rebedmos/Teremin-Eletronico/README.md

# Teremin-Eletronico
O presente projeto foi feito em 2016 e teve como objetivo aplicar:
- a criação de um conceito de projeto;
- a possibilidade de visão e operação macro e micro de um projeto de engenharia;
- o gerenciamento do projeto por meio do Project Model CANVAS;
- o estudo específico do microcontrolador RL78/G13 (arquitetura, utilização de registradores e bibliotecas);
- aplicação técnica de conhecimentos de hardware (circuitos, modulação de sinais, filtros, desacoplamento, DAC, buffer, amplificação de corrente para drive de motor, fontes, regulagem de offset, montagem, etc) e software (utilização da IDE IAR-RL78 em linguagem C, depuração em tempo real).

O projeto teve como metas definidas fazer um projeto que seja: realizável; entregável; funcional; didático; conceitualmente útil para a sociedade; de baixo custo; que envolva algo relacionado à música; que tenha impacto social para deficientes auditivos.
