rebedmos/Teremin-Eletronico/Teremin_Hardware/Electronic_Theremin2.pdf

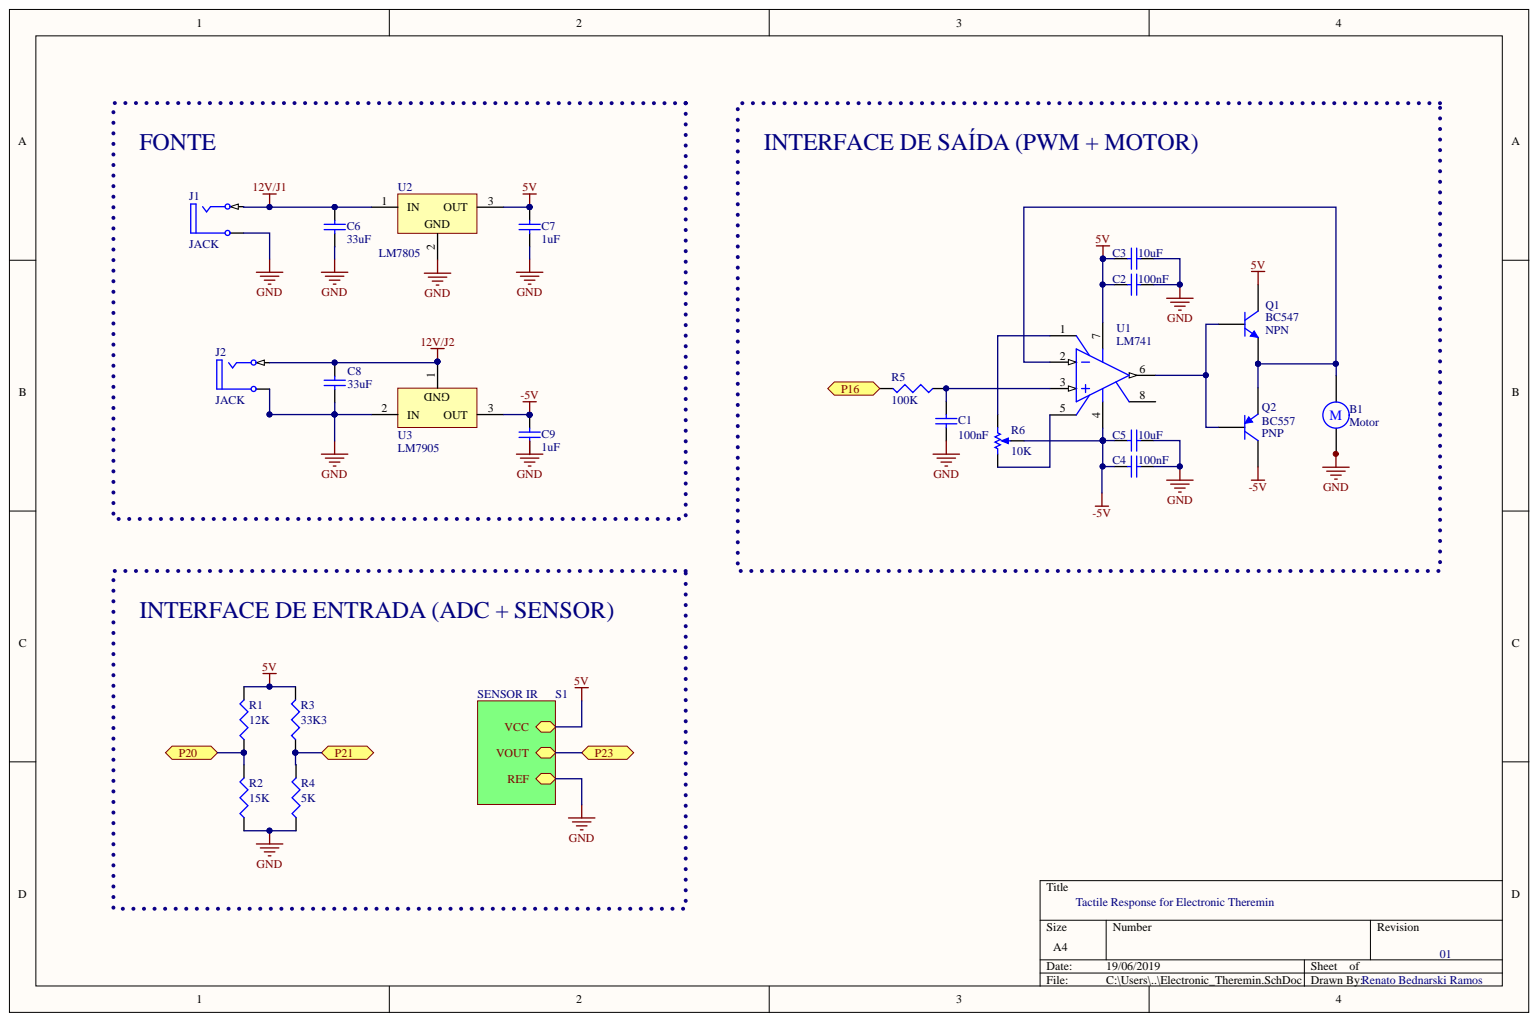
[picture p12: page 1]

INTERFACE DE SAÍDA (PWM + MOTOR)

INTERFACE DE ENTRADA (ADC + SENSOR)

Title
Tactile Response for Electronic Theremin
