rebedmos/Teremin-Eletronico/(list of files, drawings)

Other design files:
Teremin_Hardware/Electronic_Theremin.SchDoc
